RICCIARDI-Adrien/Clock/README.md

# Clock

A digital clock displaying time, date and current room temperature on a LCD display.

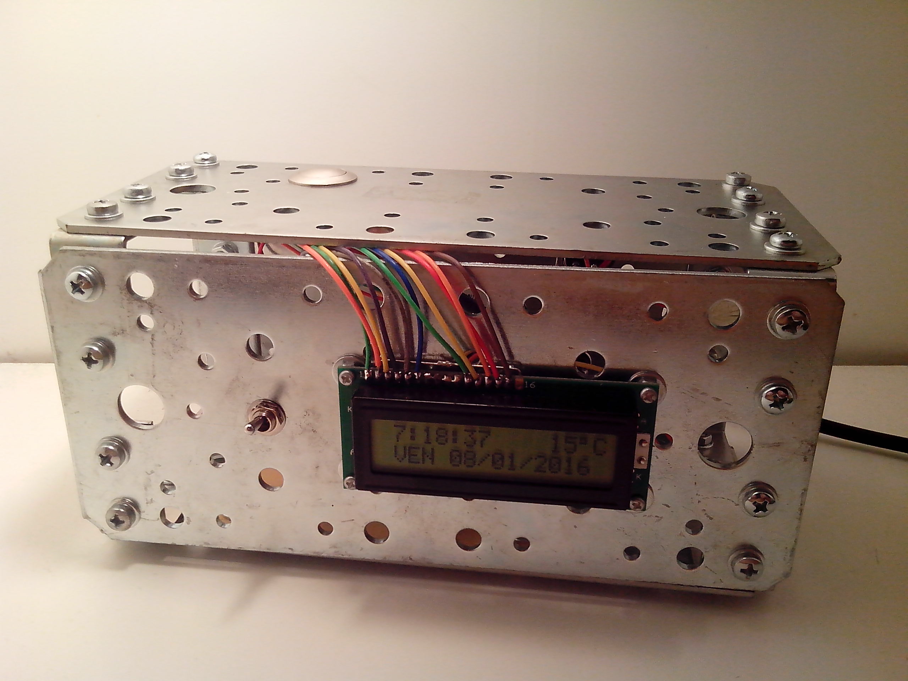
[picture p1: Resources/Clock.jpg]
Clock


## Hardware

The clock is powered by a PIC16F876 microcontroller clocked at 4MHz. It reads time and date from a DS1307 Real-Time Clock.  
Those and the temperature sampled from a LM35DZ temperature sensor are displayed on a 2x16 LCD display.  
This clock also features an alarm mode which relies on a 85dB buzzer to make the more noise possible.  
The schematics can be found in the Hardware directory. They were drawn using Cadsoft Eagle 7.5.  
  
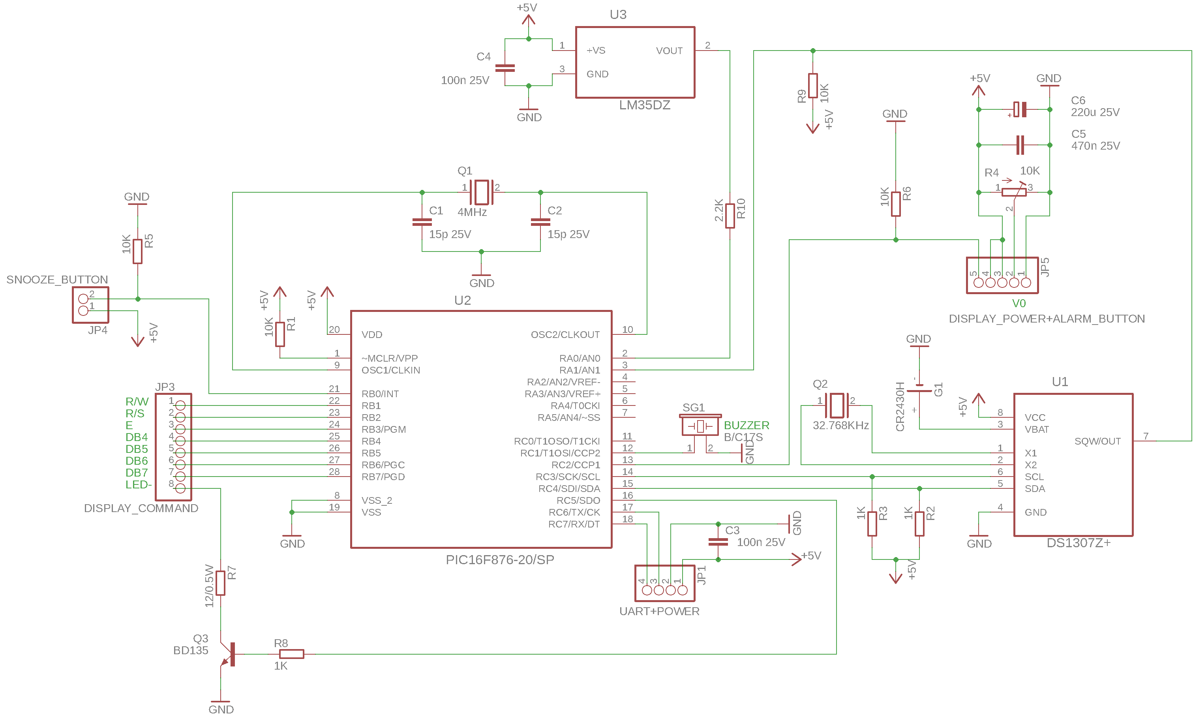
[picture p2: Resources/Main_Board_Schematics.png]
Main board schematics


## Software

The microcontroller firmware source code can be found in the Software/Microcontroller directory. The source code is a Sourceboost 7.30 BoostC project.  
The PC program uses a serial port to talk to the clock. It can be compiled using gcc on Linux systems or Cygwin on Windows.  
An Android application (working from Android 4.0.3 to latest Android version) is also available. Plug an USB to serial cable to an USB host capable Android device and use the app to program the clock. The app was compiled with Android Studio 2.2.2.  
  
Microcontroller .hex file and Android .apk can be found in the [GitHub Release page](https://github.com/RICCIARDI-Adrien/Clock/releases).

## Photo gallery

### PCB

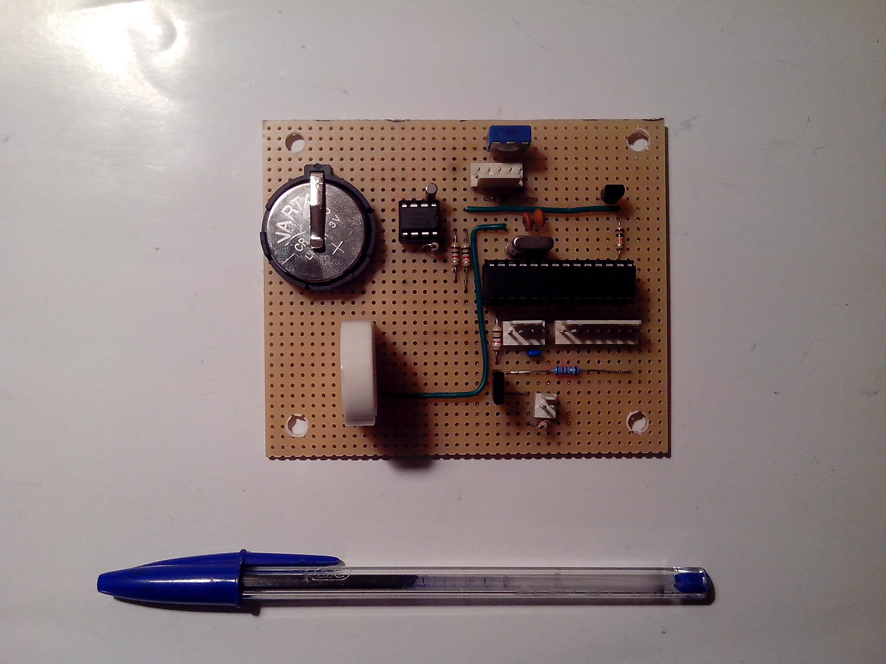
[picture p3: Resources/PCB_Top.jpg]
PCB top

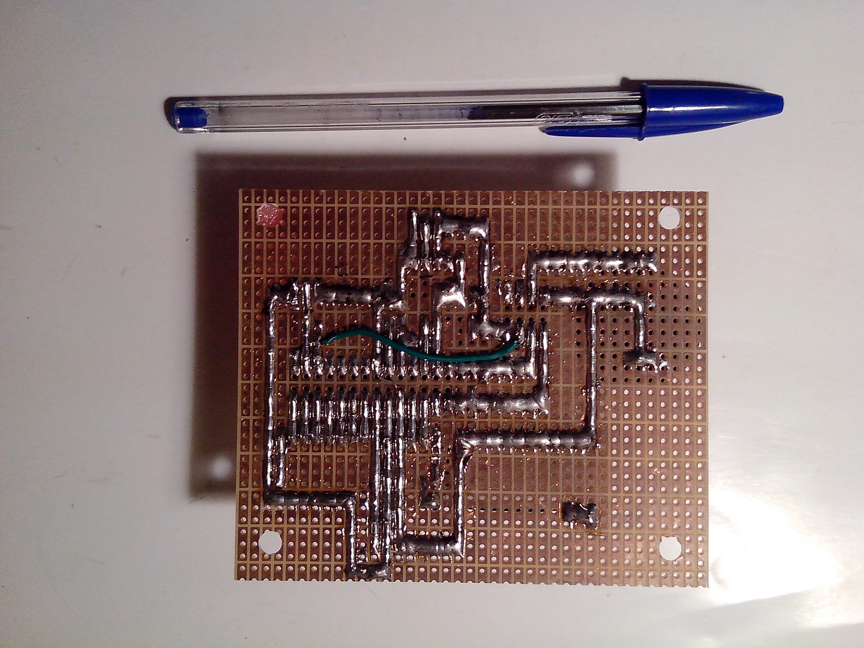
[picture p4: Resources/PCB_Bottom.jpg]
PCB bottom


### Casing assembly

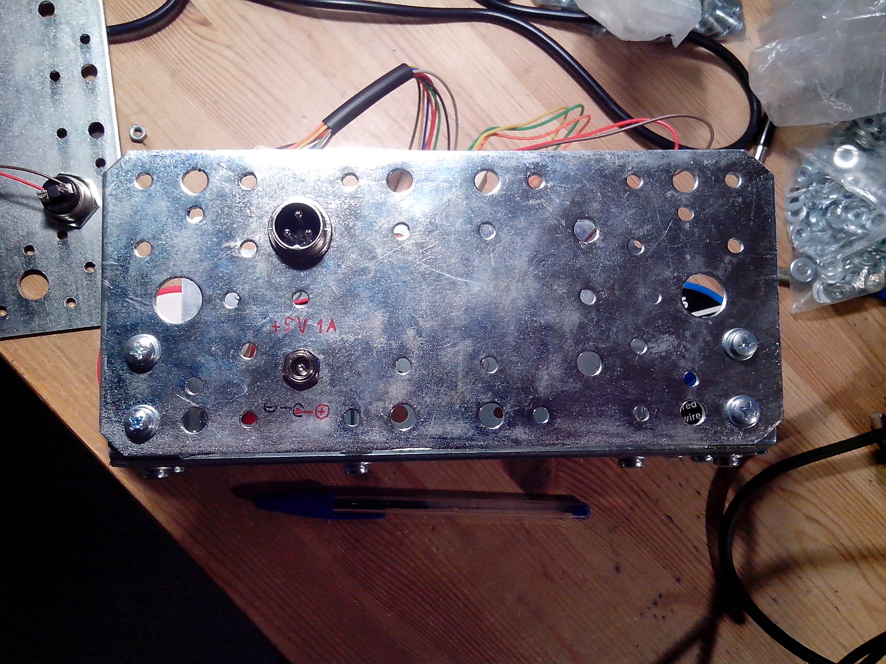
[picture p5: Resources/Casing_Rear.jpg]
Casing rear

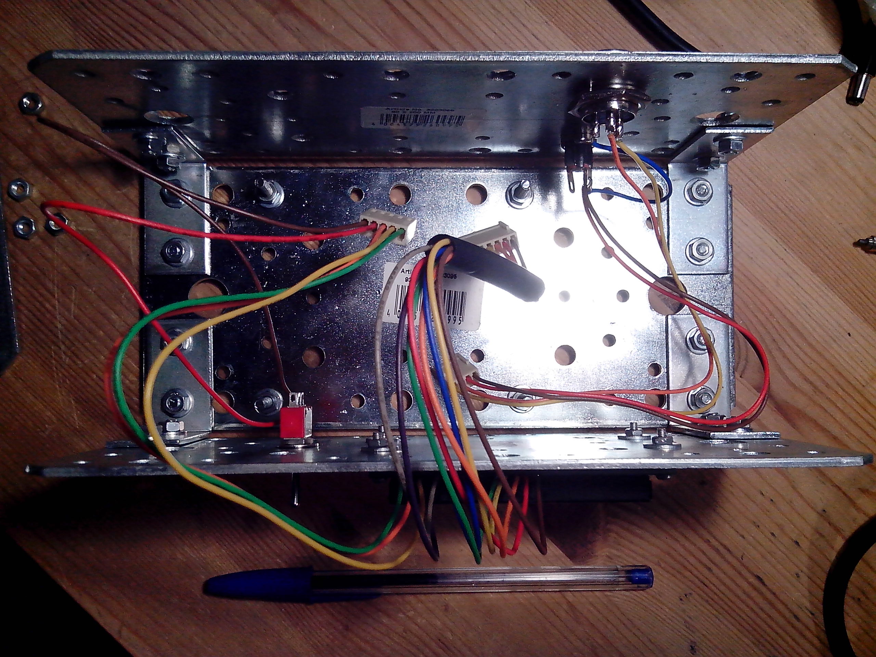
[picture p6: Resources/Assembly_1.jpg]
Assembly 1

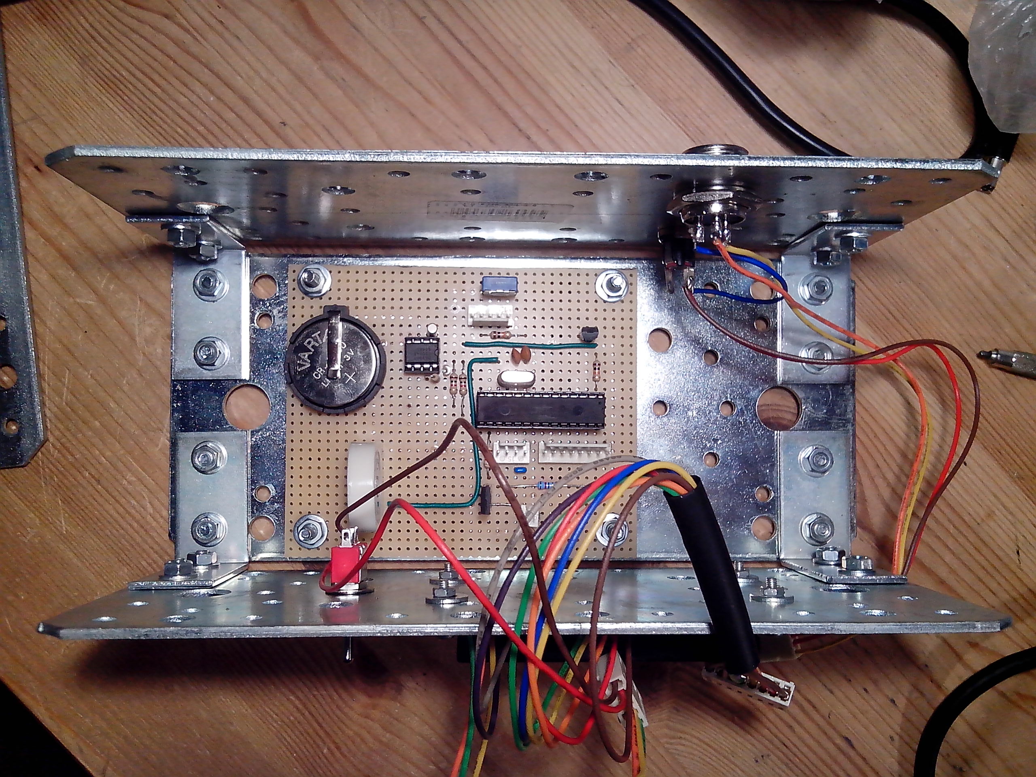
[picture p7: Resources/Assembly_2.jpg]
Assembly 2

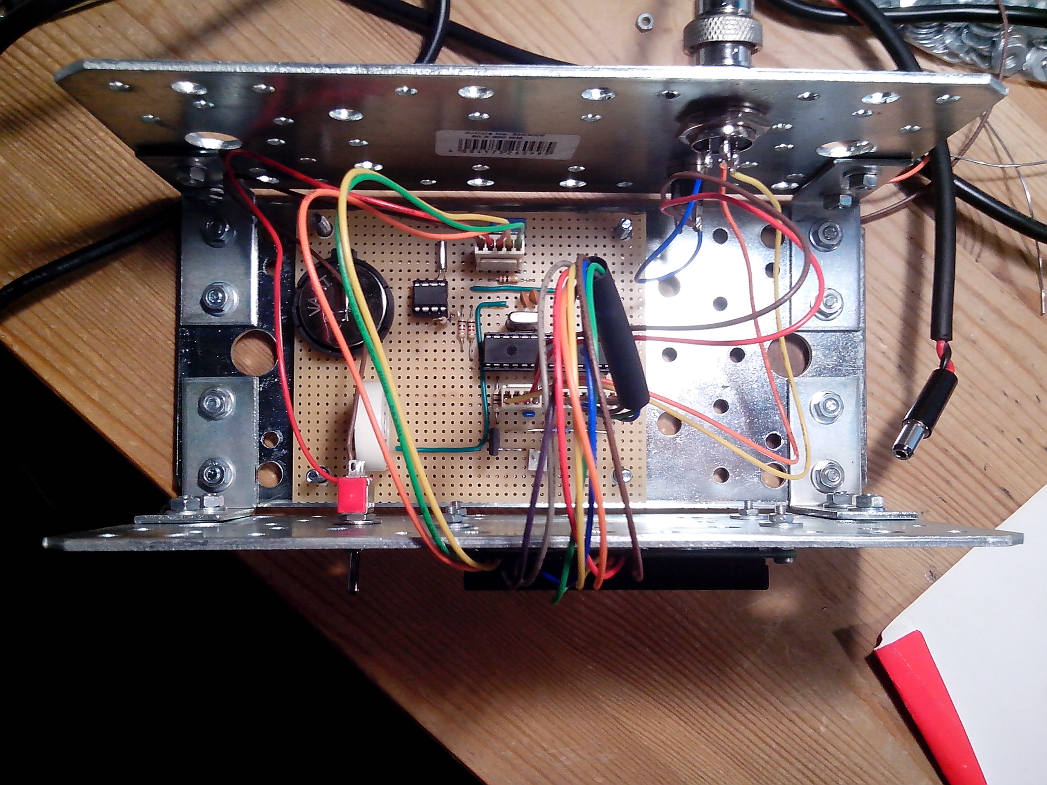
[picture p8: Resources/Assembly_3.jpg]
Assembly 3

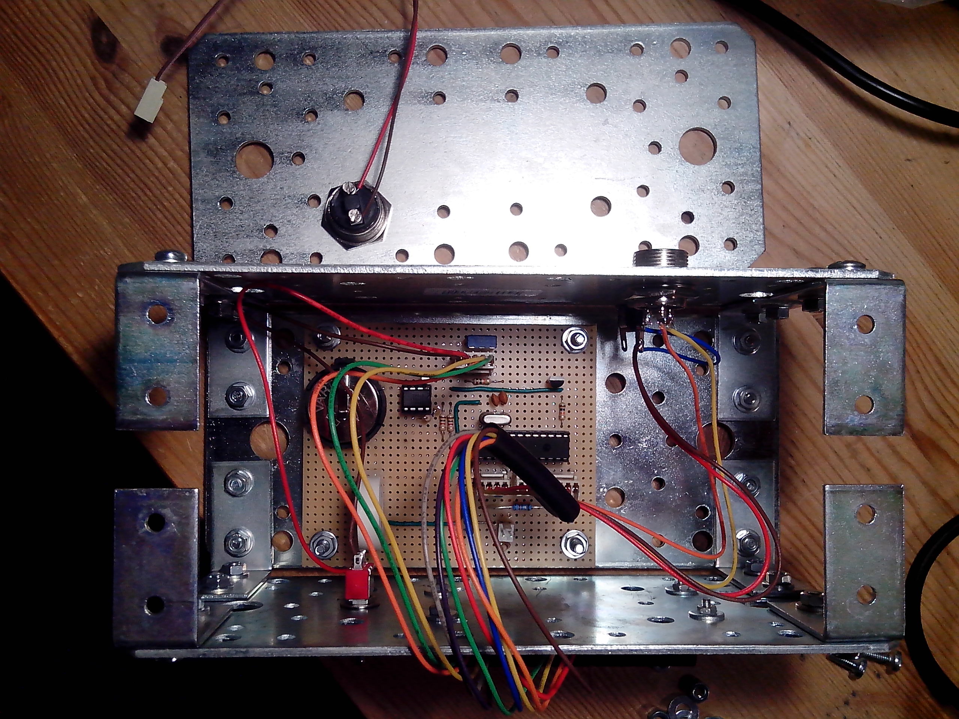
[picture p9: Resources/Assembly_4.jpg]
Assembly 4

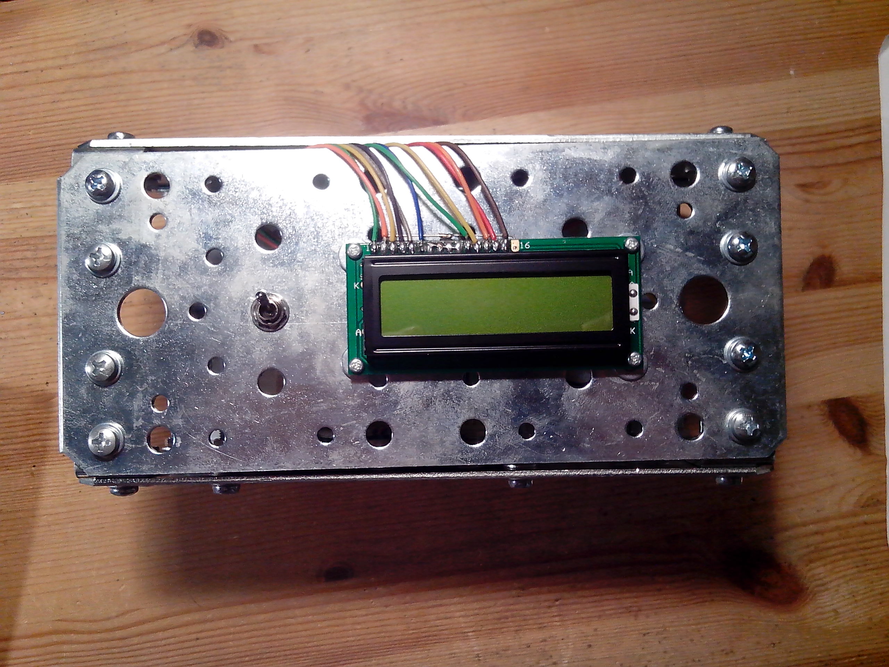
[picture p10: Resources/Assembly_5.jpg]
Assembly 5


### Backlight testing

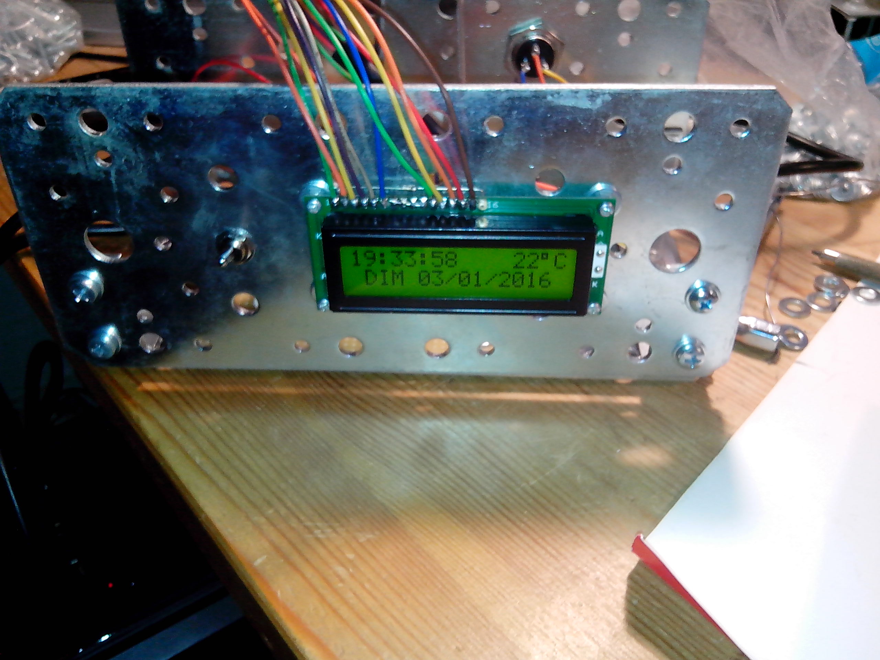
[picture p11: Resources/Backlight_Testing.jpg]
Backlight testing


### Side view

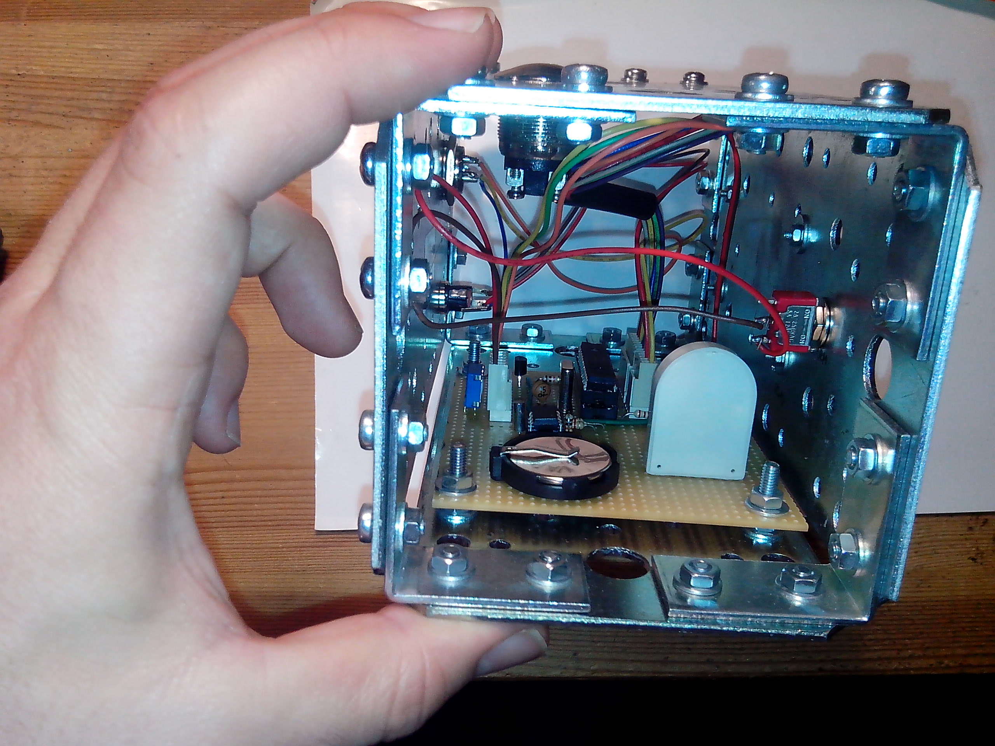
[picture p12: Resources/Side_View.jpg]
