RICCIARDI-Adrien/Clock/Hardware/Main_Board.sch

## EAGLE design Hardware/Main_Board.sch (2019-08-11)

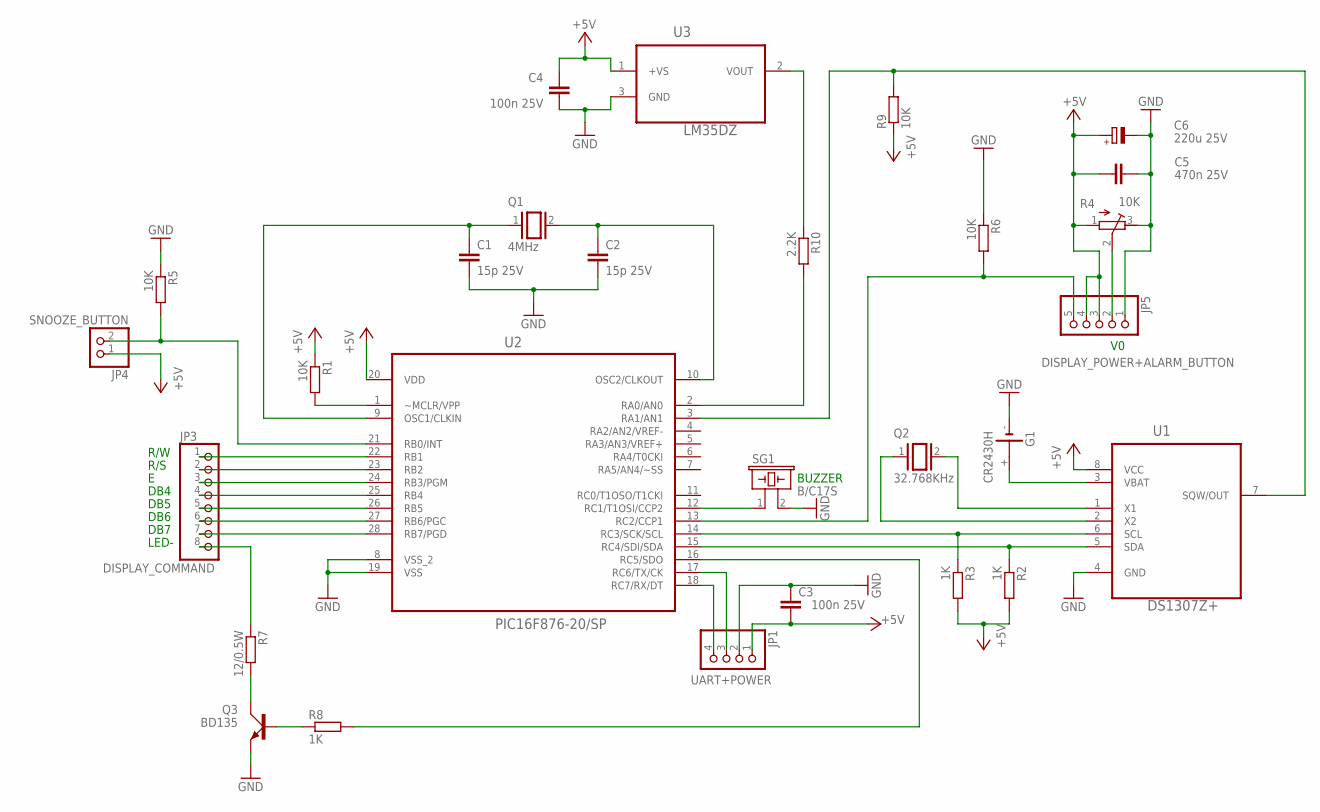
[picture p13: schematic Main_Board.sch]

Parts:
C1, C2: 15p 25V; C2.5-3
C3: 100n 25V; C5B3.5
C4: 100n 25V; C025-025X050
C5: 470n 25V; C025-025X050
C6: 220u 25V; E2,5-6
G1: CR2430H
JP1: UART+POWER; 1X04
JP3: DISPLAY_COMMAND; 1X08
JP4: SNOOZE_BUTTON; 1X02
JP5: DISPLAY_POWER+ALARM_BUTTON; 1X05
Q1: 4MHz; QS
Q2: 32.768KHz; QS
Q3: BD135; TO126AV
R1, R5, R6, R9: 10K; 0207/12
R2, R3, R8: 1K; 0207/12
R4: 10K; RTRIM3339P
R7: 12/0.5W; 0207/12
R10: 2.2K; 0207/12
SG1: B/C17S
U1: DS1307Z+; SOIC127P600X175-8N
U2: PIC16F876-20/SP; DIP254P762X406-28
U3: LM35DZ; TO127P254X495-3P

Connections:
+5V: C3.2, C4.1, C5.1, C6.+, JP1.1, JP4.1, JP5.3, JP5.4, R1.1, R2.2, R3.2, R4.1 (A), R9.1, U1.8 (VCC), U2.20 (VDD), U3.1 (+VS)
GND: C1.2, C2.2, C3.1, C4.2, C5.2, C6.-, G1.-, JP1.2, JP5.1, Q3.E, R4.3 (E), R5.1, R6.1, SG1.2, U1.4 (GND), U2.8 (VSS_2), U2.19 (VSS), U3.3 (GND)
unnamed: R1.2, U2.1 (~MCLR/VPP)
unnamed: C1.1, Q1.1, U2.9 (OSC1/CLKIN)
unnamed: C2.1, Q1.2, U2.10 (OSC2/CLKOUT)
unnamed: SG1.1, U2.12 (RC1/T1OSI/CCP2)
unnamed: Q2.2, U1.1 (X1)
unnamed: G1.+, U1.3 (VBAT)
unnamed: Q2.1, U1.2 (X2)
unnamed: R2.1, U1.5 (SDA), U2.15 (RC4/SDI/SDA)
unnamed: R3.1, U1.6 (SCL), U2.14 (RC3/SCK/SCL)
unnamed: R9.2, U1.7 (SQW/OUT), U2.3 (RA1/AN1)
unnamed: JP3.1, U2.22 (RB1)
unnamed: JP3.2, U2.23 (RB2)
unnamed: JP3.3, U2.24 (RB3/PGM)
unnamed: JP3.4, U2.25 (RB4)
unnamed: JP3.5, U2.26 (RB5)
unnamed: JP3.6, U2.27 (RB6/PGC)
unnamed: JP3.7, U2.28 (RB7/PGD)
unnamed: R8.2, U2.16 (RC5/SDO)
unnamed: JP5.2, R4.2 (S)
unnamed: JP1.4, U2.18 (RC7/RX/DT)
unnamed: JP1.3, U2.17 (RC6/TX/CK)
unnamed: JP5.5, R6.2, U2.13 (RC2/CCP1)
unnamed: JP3.8, R7.1
unnamed: JP4.2, R5.2, U2.21 (RB0/INT)
unnamed: Q3.C, R7.2
unnamed: Q3.B, R8.1
unnamed: R10.2, U2.2 (RA0/AN0)
unnamed: R10.1, U3.2 (VOUT)

Notes on the sheet:
BUZZER
DB4
DB5
DB6
DB7
R/S
R/W
LED-
