RICCIARDI-Adrien/Clock/(commit log)

2016-01-01 Made the RTC run even if it is not configured to avoid RTC_WAIT_TICK_BEGINNING() enter in infinite loop.
    [RTC.c, RTC.h]
2016-01-01 Added the UART communication protocol to the MCU firmware and added the PC software able to configure the clock.
2016-01-02 Added first version of the schematics.
    [Main_Board.sch]
2016-01-02 Displayed the schematics image directly on the repository main page.
2016-01-02 Added display command signal names, a stabilization capacitor and a missing pull-up on the RTC SQW/OUT signal.
    [Main_Board.sch]
2016-01-02 Changed some signal to ease routing.
    [Main_Board.sch]
2016-01-03 Changed in firmware the SQW/OUT RTC pin to the new one.
2016-01-03 Avoid the buzzer to ring on boot due to a random value in the corresponding port register.
    [Ring.c]
2016-01-03 Fixed a bug on the PC program that was sending a wrong month value.
    [Main.c]
2016-01-03 The temperature sensor is working and the time, date and temperature are displayed on the screen.
2016-01-03 Changed the display backlight driver transistor base resistor (R8) to 1Kohm because 100Ohm were generating Read-Modify-Write errors on the PIC port.
    [Main_Board.sch]
2016-01-03 Added a missing newline character in the PC program.
    [Main.c]
2016-01-04 Added buttons support and display backlight timer.
2016-01-05 Replaced the delay_us() calls with NOPs to be sure of the execution time.
    [Display.c]
2016-07-27 Added a decoupling resistor on the temperature sensor output as the microcontroller ADC input has a too high capacitance.
    [Main_Board.sch]
2016-11-15 Compatible serial cable can now be detected.
2016-11-17 Asked the permission to access to an USB device before opening it.
2016-12-11 Replaced the PC software UART library by a git sub-module.
    [Main.c, UART.c, UART.h]
2017-07-01 Used UART interrupt instead of blocking sequential code in the microcontroller firmware to improve PC and Android applications communication speed and robustness.
2017-07-01 Fixed some Doxygen comments syntax.
    [RTC.h]
2018-06-17 Fixed an outdated comment in microcontroller firmware.
    [Button.h]
2019-08-11 Improved hardware stability by adding decoupling capacitors.
    [Main_Board.sch]
2019-08-11 Updated schematic image.
